2268699403/Stm32_Project/基于stm32f103的两轮自平衡车/平衡车_ESP拓展/progress.md

# 进度日志

## 会话：2026-07-16

### 阶段 1：需求与发现
- **状态：** complete
- **开始时间：** 2026-07-16
- 执行的操作：
  - 分析了 STM32 平衡车完整代码结构
  - 确认 GPIO 引脚占用和可释放资源
  - 查阅 MiMo API 文档（音频理解 + TTS）
  - 确定 ESP32-S3-R16N8 硬件方案
  - 与用户确认通信方式、音色、触发方式等
  - 确认 ESP-IDF 开发框架选择

### 阶段 2：规划与结构
- **状态：** complete
- 执行的操作：
  - 设计 STM32↔ESP32 通信协议（CMD:VALUE\n 格式）
  - 设计 ESP32 任务架构（5任务+状态机）
  - 设计 API 调用流程（2轮调用：音频理解→TTS流式）
  - 绘制硬件连接方案
  - 创建规划文档(task_plan.md, findings.md, progress.md)
  - 更新 AGENTS.md
- 创建/修改的文件：
  - 平衡车_ESP拓展/task_plan.md
  - 平衡车_ESP拓展/findings.md
  - 平衡车_ESP拓展/progress.md
  - AGENTS.md (追加 ESP32 拓展章节)

### 阶段 3：STM32 侧实现
- **状态：** in_progress
- 待修改文件：
  - Hardware/USART2.h
  - Hardware/USART2.c
  - User/PID.h
  - User/main.c

### 阶段 4：ESP32 侧实现
- **状态：** pending
- 待创建文件：
  - CMakeLists.txt, sdkconfig.defaults, partitions.csv
  - main/main.c, wifi_mgr.c/h, recorder.c/h, player.c/h
  - mimo_api.c/h, uart_bridge.c/h, app_state.h

### 阶段 5：遥控器扩展
- **状态：** pending

### 阶段 6：联调与验证
- **状态：** pending

### 阶段 7：交付
- **状态：** pending

## 测试结果
| 测试 | 输入 | 预期结果 | 实际结果 | 状态 |
|---|---|---|---|---|
| (暂无) | | | | |

## 错误日志
| 时间戳 | 错误 | 解决方案 |
|---|---|---|
| (暂无) | | |

## 五问重启检查
| 问题 | 答案 |
|---|---|
| 我在哪里？ | 阶段 3 — STM32 侧实现 |
| 我要去哪里？ | 阶段 3-7：STM32改造→ESP32开发→遥控器→联调 |
| 目标是什么？ | ESP32 语音AI控制平衡车 |
| 我学到了什么？ | 见 findings.md |
| 我做了什么？ | 创建规划文档，更新 AGENTS.md |
