2268699403/Stm32_Project/原理图/平衡车底板.pdf

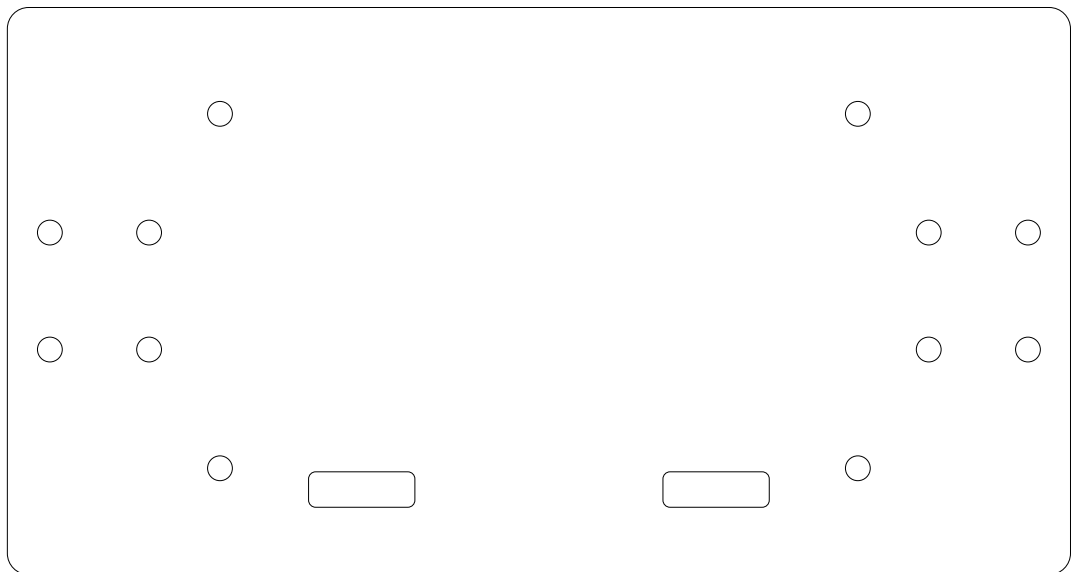
[picture p1: figure]
