2268699403/Stm32_Project/STM32F103C8T6平衡车系统开发日志.md

# STM32F103C8T6 平衡车系统 开发日志

## 2026-04-08 | 系统框架搭建与OLED驱动移植

### 今日核心目标

在Keil5 MDK环境下创建基于STM32标准外设库的工程框架。

成功移植江协科技提供的0.96寸OLED (I2C接口) 显示屏驱动程序，并完成基本功能测试。

### 具体工作内容

**工程框架搭建**：

使用STM32 Standard Peripheral Library创建了针对STM32F103C8T6的裸机工程。 完成系统时钟、GPIO、延时等基础模块的初始化配置。

**OLED驱动移植与配置**：

**硬件接口配置**： 将提供的 `OLED.c`和 `OLED.h`文件集成到工程中。将OLED的I2C引脚(SCL, SDA)配置在`GPIOB`的`Pin_8`与`Pin_9`，并初始化为开漏输出模式，在`OLED_GPIO_Init`函数中实现。

**功能验证**：调用`OLED_Init()`初始化后，依次测试了清屏(`OLED_Clear`)、显示字符串(`OLED_ShowString`)、显示数字(`OLED_ShowNum`)及画线(`OLED_DrawLine`)等基础功能，确认驱动工作正常。

### **问题与解决**

**问题**：无（驱动代码完整，移植顺利）。

### **下一步计划**

定时器开发：配置STM32通用定时器TIM1，实现精准的毫秒级定时中断，为系统提供时间基准。

## 2026-04-09 | 系统定时基准与中断服务框架搭建

### **今日核心目标**

配置STM32F103C8T6的高级定时器TIM1，实现精准的1毫秒定时中断，为整个平衡车控制系统提供稳定、可靠的时间基准，并初步建立中断服务例程的框架。

### **具体工作内容**

**定时器硬件初始化**： 根据提供的代码，完成了TIM1的完整初始化流程。使能了TIM1的APB2总线时钟，并选择内部时钟源。 完成了关键参数配置：将系统72MHz主频进行72分频，得到1MHz的计数器时钟；设置自动重装载值为999，实现每计数1000次（即1ms）产生一次更新中断。 配置了NVIC，将TIM1更新中断的抢占优先级和子优先级均设置为0，以确保中断能及时响应。

**中断服务程序开发**： 编写了标准的中断服务函数 `TIM1_UP_IRQHandler`。在函数中，首要操作是检查并清除“更新中断”标志位，这是防止中断重复进入的关键步骤。

### 关键代码

```c
// 位于 Timer_Init() 函数中的定时器结构体配置
TIM_TimeBaseInitStructure.TIM_Period = 1000 - 1;     // 自动重装载值 (ARR)
TIM_TimeBaseInitStructure.TIM_Prescaler = 72 - 1;    // 预分频器 (PSC)
// 计算公式: Tout = (ARR+1) * (PSC+1) / Tclk
// 此处: (1000) * (72) / 72,000,000 Hz = 0.001s = 1ms

// 位于 TIM1_UP_IRQHandler 中的中断服务与任务调度框架
void TIM1_UP_IRQHandler(void)
{	
    if (TIM_GetITStatus(TIM1, TIM_IT_Update) != RESET) // 1. 判断中断源
    {
		static uint16_t ms_count = 0; // 静态变量，用于软件计时
		ms_count++;
		
		/* 示例：将20ms周期任务放入中断 */
		if(ms_count >= 20)
		{
			
		}
		
        TIM_ClearITPendingBit(TIM1, TIM_IT_Update); // 2. 清除中断标志	        
    }
}
```

### **问题与解决**

**问题**：本次开发过程顺利，未遇到阻塞性技术问题。

### **下一步计划**

1. **USART串口驱动开发**：配置USART1，实现与上位机的串口通信。
2. **调试框架搭建**：基于串口，基于可变参函数自定义printf输出函数，构建一个方便的实时调试信息输出通道，便于后续PID调试、数据监控等。

## 2026-04-11 | 多路串口通信与调试框架构建

### **今日核心目标**

完成两路异步串行通信接口（USART1与USART2）的初始化与基础发送功能开发，构建可用于系统调试、参数监控及未来无线模块通信的稳定串行数据链路。核心是编写可重用的自定义格式化输出函数。

### **具体工作内容**

**双路USART硬件初始化**：

**USART1**：配置于PA9 (TX)、PA10 (RX)，挂载在APB2总线，时钟频率72MHz，初始化波特率为9600。

**USART2**：配置于PA2 (TX)、PA3 (RX)，挂载在APB1总线，时钟频率36MHz，初始化波特率同样为9600。代码中已正确处理了其总线时钟的独立使能。

两路串口均配置为：8位数据位，1位停止位，无校验位，无硬件流控制，全双工模式。

**通信函数库开发**：

为每个串口编写了分层级的发送函数：`USARTx_SendByte`（发送单字节）、`USARTx_SendString`（发送字符串）。

**关键重构**：实现了自定义的 `USARTx_Printf`函数。此函数利用C标准库的 `stdarg.h`头文件处理可变参数，内部调用 `vsprintf`将格式化的字符串输出到内部缓冲区，再通过字符串发送函数输出，完美替代了资源消耗大的标准库 `printf`，为系统调试提供了极大便利。

### 关键代码

```c
// 关键点1：USART初始化参数配置结构体 (以USART1为例)
USART_InitTypeDef USART_InitStructure;
USART_InitStructure.USART_BaudRate = 9600;
USART_InitStructure.USART_WordLength = USART_WordLength_8b;
USART_InitStructure.USART_StopBits = USART_StopBits_1;
USART_InitStructure.USART_Parity = USART_Parity_No;
USART_InitStructure.USART_Mode = USART_Mode_Rx | USART_Mode_Tx;
USART_InitStructure.USART_HardwareFlowControl = USART_HardwareFlowControl_None;
USART_Init(USART1, &USART_InitStructure);
// 注意：USART2的时钟总线（APB1）与USART1（APB2）不同，需单独使能。

// 关键点2：自定义可变参数格式化输出函数 (摘取自USART1_Printf)
void USART1_Printf(char *format, ...)
{
	char String[128];                // 临时缓冲区
	va_list arg;                    // 定义可变参数列表指针
	va_start(arg, format);          // 初始化arg，指向format后的第一个参数
	vsprintf(String, format, arg);  // 将格式化字符串写入缓冲区
	va_end(arg);                    // 结束可变参数获取
	USART1_SendString(String);      // 发送格式化后的字符串
}
// 此实现避免了直接链接标准库printf，显著节省代码空间。
```

### **遇到的问题与解决方案**

**技术难点：实现灵活的格式化输出** 

**问题**：需要实现一个类似 `printf`的函数，以支持方便地输出调试信息（如：`“Pitch: %.2f\n”`），但又不希望直接使用体积庞大的标准库 `printf`。 

**解决方案**：如关键代码所示，采用 **可变参数函数** 实现。使用 `va_list`、`va_start`、`vsprintf`和 `va_end`这一套标准流程，将格式解析和变量参数处理在用户自定义函数内完成，最终仅发送格式化完毕的字符串，实现了功能与代码体积的平衡。

**硬件连接：CH340通信失败**

**问题**：在独立供电（平衡车用电池，CH340模块接电脑USB）的情况下，仅连接TX、RX，串口无法通信，上位机接收不到数据。 

**分析与解决**：在电气上，两个独立的系统要保证通信，必须要有共同的参考地（GND）。仅连接信号线而未连接地线，会导致双方电平判断标准不一致，从而通信失败。 

**解决方案**：将CH340模块的GND引脚与STM32系统的GND（如开发板的GND引脚）用杜邦线连接，建立共地。连接后通信立即恢复正常。

### **下一步计划**

**非阻塞式按键检测开发**：利用已实现的1ms定时中断，设计一个状态机驱动的按键扫描程序，实现单击、长按的识别，且不占用主循环阻塞等待。

### 2026-04-12 | 非阻塞式按键驱动开发与状态机实现

### **今日核心目标**

完成四路独立按键的非阻塞式检测驱动开发，实现按键的单击与长按（>1秒）识别，为系统提供可靠的人机输入接口，并为后续的菜单控制、参数调整等功能奠定基础。

### **具体工作内容**

**硬件初始化**： 根据`Key.h`中的定义，将`Key1`(PB1)， `Key2`(PB0)， `Key3`(PA5)， `Key4`(PA4) 初始化为上拉输入模式。当按键未按下时，引脚被内部上拉电阻拉至高电平；按键按下时，引脚被拉至低电平。

**状态扫描函数 (`Key_Scan`)**： 该函数被放置在`TIM1`的1ms中断服务程序中，**每20ms调用一次**，实现了周期性的非阻塞扫描。 函数核心是一个**状态机**：通过对比本次读取的引脚状态(`StateX`)与上次保存的状态(`last_StateX`)，来检测按键的“按下边沿”和“释放边沿”，并分别设置`PressedX`和`ReleasedX`标志位。 在按键持续按下的周期中，软件计数器`countX`会递增，用于计时。

**模式判断函数 (`Key_Mode`)**： 此函数在主循环中被周期性调用。 其逻辑是：当检测到某个按键的`ReleasedX`（释放）标志被置位时，根据该按键按下过程中累计的`countX`值进行判断。 **判定逻辑**：若`countX >= 50`（即20ms * 50 = 1000ms），则判定为长按，`KeyX_Mode`赋值为`2`；否则判定为短按，赋值为`1`。判断完成后，将所有相关标志和计数器清零，为下一次按键事件做准备。

### **关键代码**

```c
// 关键点1：Key_Scan函数中的状态机与边沿检测 (以Key1为例)
/* 获取按键上次状态 */
last_State1 = State1;
/* 读取当前实际引脚电平 */
State1 = GPIO_ReadInputDataBit(GPIOB, GPIO_Pin_1);

if(State1 == 0 && last_State1 == 1)  // 条件1：当前按下 & 上次松开 -> 检测到按下边沿
{
    Pressed1 = 1; // 设置“按下”事件标志
}
else if(State1 == 1 && last_State1 == 0) // 条件2：当前松开 & 上次按下 -> 检测到释放边沿
{
    Released1 = 1; // 设置“释放”事件标志
}
else if(State1 == 0 && last_State1 == 0) // 条件3：持续按下状态
{
    count1++; // 按下时间计数器累加 (每20ms加1)
}
// 注意：此设计有效消除了按键抖动的影响。

// 关键点2：Key_Mode函数中的长按/短按判决 (以Key1为例)
void Key_Mode(void)
{
    if(Released1) // 仅在按键释放后进行最终判决
    {
        if(!Key1_Mode && count1 >= 50)  // 长按判决
        {
            Key1_Mode = 2; // 长按状态码
            count1    = 0; // 计数器清零
            Pressed1  = 0; // 事件标志清零
            Released1 = 0;
        }        
        else if(!Key1_Mode && count1 < 50)  // 短按判决
        {
            Key1_Mode = 1; // 短按状态码
            count1    = 0;
            Pressed1  = 0;
            Released1 = 0;
        }       
    }
}

```

### **遇到的问题与解决方案**

**问题**：在初步测试时，将`Key1_Mode`的数值实时显示在OLED上。发现长按超过1秒后，OLED能正确显示`2`（长按有效），但松开按键的瞬间，显示立刻变成了`1`（短按），逻辑出现错误。

**分析与调试**：此现象表明，在长按判决之后、按键松开之前，程序又进行了一次短按判决。检查原始代码逻辑发现，**长按判决和短按判决被放置在了不同的条件分支或执行时序中**。

**解决方案**：**将长按和短按的最终判决逻辑统一放置在“按键释放”(`ReleasedX == 1`)这个唯一的事件之后进行**，并保证只执行一次。如关键代码所示，在`Key_Mode`函数中，当检测到释放事件时，根据`countX`的值进行一次性的、排他性的判断（`countX >= 50`为长按，否则为短按），判决后立即将所有相关状态清零。这确保了一次按键动作只产生一个明确的状态结果（1或2）。

### **下一步计划**

**PCB硬件修复**：修改当前PCB中连接蓝牙模块的串口引脚网络错误，进行重新打板。

**姿态解算基础**：初始化I2C，配置MPU6050，读取姿态传感器原始数据。

## 2026-04-13 | MPU6050姿态传感器驱动开发与I2C通信实现

### **今日核心目标**

完成姿态传感器的核心驱动开发。具体包括：配置STM32的硬件I2C2外设，实现底层的单字节与多字节读写函数；完成MPU6050模块的初始化、寄存器配置，并成功读取其原始的加速度计、陀螺仪及温度数据，为后续的姿态解算奠定数据基础。

## **具体工作内容**

**I2C2硬件初始化**：

 在 `MPU6050_Init`函数中，使能了 `GPIOB`和 `I2C2`的时钟。 将 `PB10`(SCL) 和 `PB11`(SDA) 配置为**复用开漏输出** 模式，这是标准I2C通信的推荐配置。 配置I2C外设：设置模式为`I2C_Mode_I2C`，时钟速度为400kHz，占空比为`I2C_DutyCycle_2`，并启用应答。

**I2C底层读写函数开发**：

 **单字节写入 (`I2C_WriteByte`)**：严格遵循I2C协议时序，依次实现了起始信号、发送设备地址（写）、发送寄存器地址、发送数据、停止信号，并在每个步骤后通过`I2C_CheckEvent`函数检查事件标志位，确保通信可靠性。 **单字节读取 (`I2C_ReadByte`)** 与**多字节连续读取 (`I2C_ReadBytes`)**：实现了完整的读操作流程。关键点在于执行“重复起始条件”以切换读写方向，以及在读取最后一个字节前**禁用ACK**并**发送停止条件**，这是正确的I2C主机读取序列。

**MPU6050应用层驱动**： 

**设备配置 (`MPU6050_Config`)**：通过I2C写入函数，依次配置MPU6050的电源管理（唤醒）、采样率分频器（125Hz）、陀螺仪量程（±250°/s）和加速度计量程（±2g）。 **原始数据读取 (`MPU6050_GetRawData`)**：调用`I2C_ReadBytes`函数，从传感器数据寄存器（起始地址`0x3B`）连续读取14个字节，并按照数据手册格式组合成6个16位有符号整数（加速度X/Y/Z、温度、陀螺仪X/Y/Z），存入自定义的`MPU6050_Data`结构体中。

### **关键代码**

```c
// 关键点1：I2C多字节读取函数的核心流程
uint8_t I2C_ReadBytes(uint8_t DevAddr, uint8_t RegAddr, uint8_t *Data, uint8_t Len) {
    // ... 发送起始条件、设备地址（写）、寄存器地址 ...
    I2C_GenerateSTART(I2C2, ENABLE); // 发送重复起始条件
    // ... 发送设备地址（读）...
    
    /* 关键逻辑：读取前 N-1 个字节，需回复ACK */
    if(Len > 1) {
        I2C_AcknowledgeConfig(I2C2, ENABLE);
        for(uint8_t i = 0; i < Len - 1; i++) {
            while(I2C_CheckEvent(I2C2, I2C_EVENT_MASTER_BYTE_RECEIVED) == ERROR);
            Data[i] = I2C_ReceiveData(I2C2);
        }
    }
    /* 关键逻辑：读取最后一个字节前，发送NACK和STOP信号 */
    I2C_AcknowledgeConfig(I2C2, DISABLE);
    I2C_GenerateSTOP(I2C2, ENABLE);
    while(I2C_CheckEvent(I2C2, I2C_EVENT_MASTER_BYTE_RECEIVED) == ERROR);
    Data[Len-1] = I2C_ReceiveData(I2C2);
    
    I2C_AcknowledgeConfig(I2C2, ENABLE); // 恢复ACK使能，为下次通信做准备
    return 0;
}

// 关键点2：从原始字节数据合成16位传感器数据
pData->Accel_X = (buffer[0] << 8) | buffer[1]; // 高字节在前，低字节在后
pData->Accel_Y = (buffer[2] << 8) | buffer[3];
pData->Accel_Z = (buffer[4] << 8) | buffer[5];
pData->Temp    = (buffer[6] << 8) | buffer[7];
pData->Gyro_X  = (buffer[8] << 8) | buffer[9];
pData->Gyro_Y  = (buffer[10] << 8) | buffer[11];
pData->Gyro_Z  = (buffer[12] << 8) | buffer[13];

```

### **遇到的问题与解决方案**

**头文件包含与宏定义失效**：

 **问题**：在`MPU6050.c`文件中编写的代码，无法识别`MPU6050_ADDR_W`、`MPU6050_WHO_AM_I`等寄存器地址宏定义，导致编译错误。 

**原因与解决**：这些宏定义均在`MPU6050_Reg.h`头文件中。虽然`MPU6050.c`包含了`MPU6050.h`，但`MPU6050.h`中并未包含`MPU6050_Reg.h`。**C语言的编译单元是源文件(`.c`)**，每个`.c`文件需要直接包含它所依赖的所有头文件。因此在`MPU6050.c`的开头添加了`#include "MPU6050_Reg.h"`，问题解决。这是一个关于C语言编译与链接机制的重要实践认知。

**低级语法与API错误**： 

**问题**：代码中存在中文分号`；`导致编译失败；在调用`I2C_CheckEvent`函数时，使用了错误的状态标志位。

 **解决**：利用AI编程助手的实时语法检查与代码补全功能，快速定位并修正了这些笔误和API使用错误，显著提升了调试效率。

### **已验证结果**

硬件I2C2通信初始化成功，SCL/SDA波形通过逻辑分析仪验证，符合400kHz I2C标准。

MPU6050设备ID读取成功，`WHO_AM_I`寄存器返回值正确，确认通信链路畅通。

成功读取原始数据。在主函数中循环调用`MPU6050_GetRawData`，并将陀螺仪X、Y、Z轴原始值实时显示在OLED屏幕上，数值随传感器晃动而灵敏变化，验证了数据读取的完整性与正确性。

### **下一步计划**

**DMA数据传输优化**：目前采用查询方式读取MPU6050的14字节数据，会短暂阻塞CPU。计划配置DMA通道，实现I2C数据到内存数组的自动搬运，将CPU解放出来以执行更关键的控制任务，提升系统实时性。

## 2026-04-17 | 电机驱动与控制执行器开发

### **今日核心目标**

完成平衡车核心执行机构——直流减速电机的驱动与控制。具体包括：配置`TIM2`定时器的两路PWM输出通道，生成用于电机调速的PWM波形；编写完整的电机驱动模块，实现对左右电机**正转、反转、停止**三种状态以及**无级调速**的精确控制。

### **具体工作内容**

**PWM波形生成（`PWM.c/.h`）**： 

**定时器配置**：初始化`TIM2`，时钟源选择内部时钟。通过配置预分频器(PSC)=0和自动重装载寄存器(ARR)=7199，将PWM波形频率设置为10kHz。计算过程：定时器时钟为72MHz，PWM频率 = 72MHz / ((PSC+1)*(ARR+1)) = 72,000,000 / (1 * 7200) = 10,000 Hz。此频率可有效避免电机产生可闻噪音。

 **PWM通道配置**：配置`TIM2`的通道1(PA0)和通道2(PA1)为PWM模式1，输出极性高有效，并启用输出。通过`TIM_SetComparex()`函数动态修改比较寄存器(CCRx)的值，实现占空比0-100%的调节。

**电机驱动模块（`Motor.c/.h`）**：

 **硬件接口**：使用`GPIOB`的`Pin12~15`作为TB6612电机驱动芯片的控制引脚，分别控制左右电机的方向（AIN1/AIN2, BIN1/BIN2）。 

**功能抽象**：提供了高度封装的API函数。 Motor_Init(): 初始化PWM及控制GPIO。 Motor_Direction(Motor_Id, Direction): 控制电机转向（正转`FWD`、反转`REV`、制动`STOP`）。

**关键点**：代码中根据电机ID（`Motor_L`/`Motor_R`）分别映射到正确的GPIO，并考虑了左右电机安装方向相反导致的“正转”定义不同。 `Motor_Speed(Motor_Id, Duty)`: 设置指定电机的PWM占空比（0-100），实现调速。 `Motor_Stop()`: 同时制动两个电机（将驱动芯片输入置为同电平，电机快速停止）。

**系统集成与测试（`main.c`）**： 

在主函数中编写了测试循环，交替控制左右电机以20%的占空比进行正转、反转、停止各0.5秒的周期性运动，验证了驱动电路与代码逻辑的正确性。

### 关键函数

```c
// TIM2 PWM定时器基础配置 (PWM.c)
TIM_TimeBaseInitStructure.TIM_Period = 7200 - 1;      // 自动重装载值 ARR
TIM_TimeBaseInitStructure.TIM_Prescaler = 0;          // 预分频器 PSC
// 计算得 PWM 频率 = 72MHz / ((0+1)*(7200)) = 10 kHz
// 计算得 PWM 分辨率 = 7200 counts

// 电机方向控制函数中的逻辑判断 (Motor.c)
void Motor_Direction(uint8_t Motor_Id, uint8_t Direction) {
    if (Motor_Id == Motor_L) { // 左电机控制逻辑
        if (Direction == Motor_FWD) { // 左电机“正转”定义为前进方向
            GPIO_SetBits(GPIOB, BIN_2);
            GPIO_ResetBits(GPIOB, BIN_1);
        } else if (Direction == Motor_REV) { // 反转
            GPIO_SetBits(GPIOB, BIN_1);
            GPIO_ResetBits(GPIOB, BIN_2);
        } else if (Direction == Motor_STOP) { // 制动（短路刹车）
            GPIO_SetBits(GPIOB, BIN_1);
            GPIO_SetBits(GPIOB, BIN_2);
        }
    } else if (Motor_Id == Motor_R) { // 右电机控制逻辑
        if (Direction == Motor_FWD) { // 右电机“正转”定义为前进方向
            GPIO_SetBits(GPIOB, AIN_1);
            GPIO_ResetBits(GPIOB, AIN_2);
        }
        // ... 其他状态类似
    }
}
// 注：AIN1/AIN2控制右电机，BIN1/BIN2控制左电机，正反转电平逻辑相反以实现同向转动。
```

### **遇到的问题与解决方案**

**问题**：在初步调试时，电机仅能极其缓慢转动，即使将PWM占空比设置为100%，也无力带动车轮。

**分析与调试**： TB6612在仅接`VCC`未接`VM`时，其内部逻辑电路可工作，H桥功率输出级无法正常工作，但可能存在极微弱的漏电流导致电机能“蠕动”，造成了“有控制信号但无力”的现象。

**解决方案**：为电机驱动模块接入独立的`VM`功率电源，并确保与单片机的`GND`共地。接通后，电机立即能有力、快速地响应调速指令。

### **已验证结果**

 用示波器测量`PA0`和`PA1`引脚，确认产生了频率10kHz、占空比可精确调控的PWM波形。

左右电机可独立受控，分别实现正转、反转、制动，且转动方向符合代码中为平衡车定义的“前进”方向。

`Motor_Speed`函数控制线性度良好，占空比从10%到90%变化时，电机转速呈现明显的阶梯变化。

急停功能(`Motor_Stop`)响应迅速，电机能在短时间内停止，无明显滑行。

### **项目风险与调整记录**

**DMA数据搬运计划暂停**：在尝试为MPU6050的I2C通信配置DMA时，程序在`I2C_CheckEvent`的等待循环中卡死，初步判断为I2C总线状态机与DMA传输时序冲突导致的死锁。为确保项目主干进度，决定暂时搁置DMA优化，维持当前查询式读取。此优化将在主体控制算法稳定后，作为性能提升点重新评估。

### **下一步计划**

**编码器接口与速度反馈**：配置`TIM3`和`TIM4`的编码器接口模式，用于读取连接在左右电机上的正交编码器信号，从而获取电机的实时转速，为后续的速度闭环PID控制提供反馈量。

**速度计算任务**：编写一个在定时中断中运行的函数，定期读取编码器计数值并换算为实际转速。

## 2026-04-18 | 编码器测速与蓝牙模块重置

### **今日核心目标**

实现平衡车速度闭环控制的关键反馈环节。具体包括：完成`TIM3`和`TIM4`的正交编码器接口模式配置，以捕获电机编码器脉冲；在系统1ms定时中断中周期性地读取并计算左右电机的实时转速（RPM）与方向；重置蓝牙模块，为后续的无线调参与监控做好准备。

### **具体工作内容**

**编码器硬件接口配置（`Encoder_Init`）**：

使能了`TIM3`、`TIM4`及对应GPIO的时钟。将编码器A/B相输入引脚配置为上拉输入模式(`GPIO_Mode_IPU`)。配置`TIM3`和`TIM4`的时基单元，设置`Prescaler=1-1`, `Period=65536-1`，将计数器配置为16位无符号模式。

调用`TIM_EncoderInterfaceConfig`函数，将定时器工作模式设置为`TIM_EncoderMode_TI12`，此模式可同时对A、B两相的边沿进行计数，实现四倍频和提高测向精度。

根据电机物理安装方向，分别设置`TIM3`和`TIM4`的输入捕获极性，以匹配实际的转向逻辑。

**测速算法实现与系统集成**：

测速函数（`Encoder_GetState`）：在`Timer.c`的`TIM1_UP_IRQHandler`中断服务函数中，每10ms调用一次此函数。函数读取`TIM3`和`TIM4`的计数器值（`CNT`），并立即将计数器清零，为下一个10ms周期做准备。

转速计算：通过公式 `RPM = (脉冲计数 * 6000.0f) / (编码器单圈脉冲数44 * 减速比9.6)`将周期内的脉冲数转换为转速（RPM）。编码器分辨率为11线（四倍频后44），电机减速比为9.6。

主循环应用：在`main.c`中，将计算得到的`RPM_L`和`RPM_R`实时显示在OLED屏幕上，并进行验证。

**蓝牙模块修复**：

根据数据手册，将模块的P16引脚接地100ms，重置出厂设置，通过串口助手发送`AT`指令，成功接收到`OK`响应，确认模块通信功能恢复正常，为后续的无线数据传输扫清了障碍。

### 关键代码

```c
// TIM3/TIM4 编码器接口模式配置 (Encoder.c)
TIM_EncoderInterfaceConfig(TIM3, TIM_EncoderMode_TI12, TIM_ICPolarity_Rising, TIM_ICPolarity_Rising);
TIM_EncoderInterfaceConfig(TIM4, TIM_EncoderMode_TI12, TIM_ICPolarity_Rising, TIM_ICPolarity_Rising);
// 参数说明：TIM_EncoderMode_TI12 表示在TI1和TI2的边沿都计数，实现4倍频。
// 后两个参数分别设置通道1和通道2的输入捕获极性，需根据编码器实际相位和电机转向调整。

// 周期性的转速计算与计数器清零 (Encoder.c)
void Encoder_GetState(void)
{
    int16_t Count_L = TIM_GetCounter(TIM4); // 获取左电机编码器在10ms内的脉冲计数值
    int16_t Count_R = TIM_GetCounter(TIM3); // 获取右电机编码器在10ms内的脉冲计数值
    // 转速换算公式：RPM = (ΔCount * (1000ms/10ms) * 60s) / (PPR * GearRatio)
    RPM_L = (Count_L * 6000.0f) / (44.0f * 9.6f); // 左电机转速
    RPM_R = (Count_R * 6000.0f) / (44.0f * 9.6f); // 右电机转速
    // 清零计数器，为下一个测量周期做准备
    TIM_SetCounter(TIM3, 0);
    TIM_SetCounter(TIM4, 0);
}

// 在1ms定时中断中调度测速任务 (Timer.c)
void TIM1_UP_IRQHandler(void)
{
    if (TIM_GetITStatus(TIM1, TIM_IT_Update) != RESET)
    {
        static int count_e = 0;
        count_e++;
        if(count_e >= 10) // 每10ms执行一次
        {
            Encoder_GetState(); // 执行测速
            count_e = 0;
        }
        TIM_ClearITPendingBit(TIM1, TIM_IT_Update);
    }
}
```

### **遇到的问题与解决方案**

**1**.**编码器无计数与电机转向错误**： 

**问题**：读取`TIM3`/`TIM4`的`CNT`寄存器值始终为0，且`Motor.c`中定义的电机转向与实际物理转向不符。 

**分析与调试**： 首先检查代码，确认编码器接口配置正确。 使用万用表测量编码器模块的VCC和GND引脚，发现电压反向。进一步检查杜邦线接线，发现编码器电机的电源线与信号线在接插件上对称接反，导致编码器未上电，自然无法计数。此接线错误也导致之前`Motor.c`中为修正物理转向而定义的宏与实际GPIO映射关系混乱。 

**解决方案**：重新正确连接编码器接线。同时，摒弃了在`Motor.h`中使用自定义宏映射引脚号的方案，改为在`Motor.c`的`Motor_Direction`函数中直接使用`GPIO_Pin_x`等标准库宏定义来控制具体引脚，消除了因宏定义映射错误导致逻辑混乱的风险。

**2**.**Keil编译缓存导致控制失效**： 

**问题**：在修复电机转向逻辑，交换了`Motor.h`中部分控制引脚的宏定义名称后，重新编译下载程序，电机无任何响应。 

**原因与解决**：怀疑是Keil MDK的编译缓存或头文件依赖关系未及时更新，导致实际生效的宏定义与源代码不一致。解决方案是执行一次“Rebuild All”，并删除工程目录下的`Objects`和`Listings`输出文件夹，确保完全重新编译。为从根本上避免此类问题，采纳了解决方案1中的做法，减少了中间宏定义的层级。

**3**.**蓝牙模块无响应**： 

**问题**：尝试通过串口发送AT指令配置HC-04蓝牙模块，模块无任何回复。

 **解决**：查阅模块数据手册，找到出厂重置方法。将模块的16引脚RST拉低100ms进行复位，随后通过串口发送`AT`，成功收到`OK`回复，模块恢复至默认状态。

### **已验证结果**

左右电机的编码器信号能被`TIM3`/`TIM4`正确捕获，`CNT`值随轮子转动而变化。

在`main`函数的循环中，通过OLED屏幕能稳定显示计算出的`RPM_L`和`RPM_R`数值，该数值能正确反映电机的正转、反转和停止。

电机控制方向与编码器测得的转向符号一致，验证了物理接线与软件逻辑已匹配。

蓝牙模块AT指令通信恢复正常，为后续开发奠定了基础。

**下一步计划**：

**完善USART2蓝牙传输功能**：基于已修复的蓝牙模块，编写数据打包与发送函数，将电机转速等系统状态通过蓝牙发送到上位机。

**驱动代码优化与封装**：对现有模块的接口和初始化流程进行梳理和优化，提高代码的模块化程度和可读性。

**准备姿态解算**：开始研究并编写MPU6050传感器数据的滤波与融合算法，为平衡车最核心的姿态控制环节做准备。

## 2026-04-19 | 传感器融合与姿态解算实现

### **今日核心目标**

完成平衡车最核心的姿态感知环节。具体包括：优化底层驱动代码的稳定性与响应逻辑；基于MPU6050的原始数据，分别通过加速度计和陀螺仪计算俯仰角，并运用互补滤波算法进行数据融合，最终输出一个稳定、准确且动态响应良好的俯仰角，为后续的直立控制提供可靠的状态输入。

### **具体工作内容**

**驱动层稳定性与逻辑优化**： 

**按键逻辑优化**：将`Key_Mode`函数的判断逻辑从“仅在松手(`Released`)时判决”优化为“长按超过1秒（`count >= 50`）时立即更新状态，短按仍在松手时判决”。此举使长按触发更及时，提升了人机交互体验。 **I2C通信加固**：在`MPU6050.c`的`I2C_ReadByte`和`I2C_ReadBytes`等函数中，将所有`while(I2C_CheckEvent(...))`循环替换为自定义的`WaitEvent`函数。该函数内置超时退出机制，有效防止了因I2C总线被意外干扰而导致的程序永久卡死，显著提升了系统鲁棒性。

**姿态解算算法实现与调试**：

 **传感器数据处理**： 加速度计俯仰角 (`AngleAcc`)：利用 `atan2(Accel_X, Accel_Z) * 180 / π`公式计算。`atan2`函数可正确处理四个象限，得到范围在-180°~180°之间的角度。此角度在静态时准确，但动态响应慢且易受线性加速度干扰。 陀螺仪俯仰角 (`AngleGyro`)：对陀螺仪Y轴（俯仰轴）的角速度进行积分。公式为：`AngleGyro = Angle + (-Gyro_Y / 32768 * 2000 * 0.01)`。其中，`-Gyro_Y`用于统一方向，`2000`对应量程±2000°/s，`0.01`是10ms的积分周期（`dt`）。此角度动态响应好，但存在积分漂移。 **互补滤波融合**：采用一阶互补滤波公式 `Angle = Kp * AngleAcc + (1 - Kp) * AngleGyro`。设置较小的`Kp=0.01`，意味着最终角度`Angle`主要由陀螺仪积分结果主导，同时用加速度计角度对其低频漂移进行微量修正，实现了优势互补。 **传感器校准**：在`MPU6050_GetRawData`函数中，对陀螺仪Y轴数据进行了零偏校准（`pData->Gyro_Y -= 43`），以抑制其零点漂移，这是减小姿态角稳态误差的关键步骤。

**系统调度与架构优化**：

 将`MPU6050_GetRawData`函数的调用从主循环移至`TIM1`的1ms定时中断服务函数中，并设置为每10ms执行一次。这为I2C总线操作提供了稳定的、可控的时序间隔，避免了主循环中高频调用可能导致的I2C状态机冲突，从系统架构上杜绝了卡死的风险。

### 关键代码

```c
// 计算基于加速度计的俯仰角（单位：度）
AngleAcc  = atan2(pData->Accel_X, pData->Accel_Z) * 180.0f / 3.14159f;
// 计算基于陀螺仪积分的俯仰角（单位：度）
AngleGyro = Angle + (-pData->Gyro_Y / 32768.0f) * 2000.0f * 0.01f;
// 一阶互补滤波融合
float Kp = 0.01f; // 加速度计权重，取值较小以信任陀螺仪
Angle = Kp * AngleAcc + (1.0f - Kp) * AngleGyro;

// I2C事件等待超时机制 (MPU6050.c)
void WaitEvent(I2C_TypeDef* I2Cx, uint32_t I2C_EVENT)
{
    uint32_t timeout = 50000; // 超时计数
    while(I2C_CheckEvent(I2Cx, I2C_EVENT) == ERROR)
    {
        timeout--;
        if(timeout <= 1) // 超时后强制跳出，避免死锁
        { break; }
    }    
}
// 应用示例：在I2C_ReadByte等函数中，用WaitEvent替换原有的while(I2C_CheckEvent...)

// 定时中断中的任务调度 (Timer.c)
void TIM1_UP_IRQHandler(void)
{
    if (TIM_GetITStatus(TIM1, TIM_IT_Update) != RESET)
    {
        static int count_1 = 0;
        count_1++;
        if(count_1 >= 10) // 10ms任务
        {
            MPU6050_GetRawData(&Data); // 姿态解算
            Encoder_GetState();        // 速度反馈
            count_1 = 0;
        }
        // ... (其他任务)
        TIM_ClearITPendingBit(TIM1, TIM_IT_Update);
    }
}
```

### **遇到的问题与解决方案**

**蓝牙模块无法连接**：

 **问题**：HC-04蓝牙模块可以通过USB转串口进行AT指令配置和问答，但无法与手机等设备完成配对连接。 

**分析与解决**：此问题可能由多种原因导致，如模块工作模式（主/从）设置错误、配对密码不正确、或硬件射频部分损坏。

**作为风险记录**：目前暂不影响核心算法开发，但需后续排查。

**主循环高频读取MPU6050导致卡死**： 

**问题**：初期在主循环中无延迟地调用`MPU6050_GetRawData`，程序运行不久后卡死。 

**原因**：I2C通信是阻塞式且有时序要求的。在主循环中超高频率调用，会导致I2C状态机尚未完成上一次操作，就开始了下一次，标志位混乱，最终卡在等待事件的`while`循环中。 

**解决方案**：采取了双重保障。架构上，将读取函数移至10ms定时中断，保证调用间隔。代码上，为所有I2C事件等待增加了`WaitEvent`超时机制。两者结合，彻底解决了此问题。

**串口打印触发硬错误（HardFault）**： 

**问题**：调用`USART1_Printf`输出角度值时，系统进入硬错误中断，程序崩溃。 

**原因**：`USART1_Printf`函数内部使用`vsprintf`将格式字符串写入一个固定大小的栈数组`String[128]`。当格式化输出的字符串长度超过128字节时，会发生栈缓冲区溢出，破坏相邻内存，从而触发硬错误。 

**解决方案**：将`vsprintf`替换为更安全的`vsnprintf`。`vsnprintf`的第三个参数指定了目标缓冲区的大小，可以防止写入越界。

### **已验证结果**

按键长按响应优化有效，体验提升。

I2C超时机制有效，在模拟拔插传感器时，程序能从错误中恢复，而非永久卡死。

姿态解算成功。OLED屏幕上实时显示的`Angle`数值稳定，传感器静止时波动小于0.5°，快速转动时能平滑、快速地跟踪，无显著漂移。`AngleAcc`和`AngleGyro`的数值特性符合预期。

陀螺仪零偏校准（`-43`）有效，显著降低了平衡车静止时的角度漂移速度。

### **下一步计划**

**优化调试输出**：针对`vsnprintf`效率较低的问题，评估影响。优化数据发送函数，或仅在需要时使能调试输出。

**实现直立控制**：引入PID控制算法。首先设计直立环（角度环），以融合后的`Angle`作为反馈，计算PWM输出控制电机，尝试让小车在手动扶正后能短暂保持直立。

## 2026-04-20 | 直立环PID控制实现与系统调优

### **今日核心目标**

实现平衡车最核心的控制功能——直立环控制。基于已解算出的稳定俯仰角，设计并调试角度环PID控制器，最终使平衡车在无人扶持的情况下能够实现动态平衡，并完成相关驱动模块的优化与调试框架的完善。

### **具体工作内容**

**调试框架完善**： 成功修复了蓝牙模块（USART2）的通信功能。通过上位机软件实时接收并图形化显示角度目标值、实际值及PID输出的波形，为PID参数整定提供了直观、高效的视觉反馈工具。

**电机驱动模块优化**： 重构了`Motor_Direction`函数，将电机“方向”与“速度”的控制逻辑统一。函数输入参数`Duty`为`int16_t`类型的有符号数，其符号代表转向（正为前进，负为后退），绝对值代表PWM占空比。此举简化了上层控制逻辑，使PID输出可直接作为电机输入。

**直立环PID控制器实现与调参**： **控制器设计**：在`PID.c`中实现了增量式PID算法。`PID_Update`函数依次计算比例项(`Kp*Error`)、积分项(`Ki*ErrorInt`)和微分项(`Kd*dError`)。 **系统集成**：在`Timer.c`的10ms定时中断中，调用`PID_Angle_Update`函数。该函数以融合后的`Angle`作为反馈量(`Actual`)，以`0`作为目标值(`Target`)，计算PID输出，并转换为左右电机的PWM信号。 **参数整定**：通过观察上位机波形和车身响应，采用试凑法，依次调节`Kp`（影响回复力刚度）、`Kd`（抑制振荡）和`Ki`（消除稳态误差），最终将直立环参数整定为：`Kp=2.5`, `Ki=0.07`, `Kd=3.0`。平衡车可在手动扶正后，维持数秒的稳定直立。

### 关键代码

```c
//增量式PID算法核心 (PID.c - PID_Update函数)
void PID_Update(PID_struct *p)
{
    p->Error1 = p->Error0;                     // 保存上次误差
    p->Error0 = p->Target - p->Actual;         // 计算本次误差
    p->ErrorInt += p->Error0;                  // 误差积分（已做积分分离判断）

    // 计算PID输出：Out = Kp*e + Ki*∑e + Kd*(e - e_last)
    p->Out = p->Kp * p->Error0
           + p->Ki * p->ErrorInt
           + p->Kd * (p->Error0 - p->Error1);
    
    // 输出限幅，防止饱和
    if (p->Out > p->OutMax) p->Out = p->OutMax;
    if (p->Out < p->OutMin) p->Out = p->OutMin;
}

//电机死区与最小启动电压处理 (Motor.c - Motor_Direction函数)
if(Duty < 5 && Duty > 1){Duty = 5;}     // 1~5 区间的占空比统一提升至5
else if(Duty < -1 && Duty > -5){Duty = -5;} // -5~-1 区间统一降至-5
if(Duty > 1){ /* 正转逻辑 */ }          // 死区：-1 ≤ Duty ≤ 1 时，电机停止
else if(Duty < -1){ /* 反转逻辑 */ }
else { /* 停止逻辑 */ }
// 此处理解决了电机“启动电压”不足导致的卡顿，并消除了零点附近的抖动。

//10ms中断中的直立环调度与安全判断 (Timer.c - TIM1_UP_IRQHandler)
if(config == 1) // 平衡使能标志
{
    LED_ON(); // 指示灯亮，表示平衡模式开启
    if(Angle <= -50 | Angle >= +50) // 安全倾角监测，超过50度急停
    {
        LED_OFF();
        Motor_Stop();
    }
    else
    {
        PID_Angle_Update(); // 执行直立环PID控制
    }
}
```

### **遇到的问题与解决方案**

**电机控制参数异常**：

 **问题**：优化`Motor_Direction`函数后，传入的`Duty`参数值异常，与预期相差很大。 

**原因与解决**：检查发现，函数原型中的`Duty`参数类型仍为`uint8_t`。而PID输出为有符号整数，导致赋值时发生数据截断与符号解释错误。将形参类型修改为`int16_t`后，问题解决。

**电机运行中偶发卡顿/急停**：

 **问题**：调参过程中，电机在转动时会突然停止，造成车身剧烈抖动。 

**分析与调试**：在`PID_Angle_Update`函数中，用于暂存左右电机PWM计算结果的局部变量`PWM_L`, `PWM_R`, `AvePWM`, `DifPWM`在声明时未初始化。其初始值为栈内存中的随机数，在某些情况下会干扰最终计算结果，导致`Motor_Direction`函数收到接近0的占空比，触发停止逻辑。

 **解决**：在声明这些局部变量时，全部初始化为`0`。

**平衡车单向加速运动**：

 **问题**：调参时，小车总是缓慢地朝一个方向加速运动直至倒下，无法在零点附近维持。

 **原因**：当倾角很小时（如2°以内），PID计算出的`Duty`值很小（1~5）。此占空比低于电机的静摩擦力矩对应的启动电压，电机实际不转或转速极低，无法产生足够的回复力。

 **解决**：在`Motor_Direction`函数中增加死区与最小输出处理。将`1~5`和`-5~-1`区间的占空比统一提升至`5`和`-5`，并设置`-1~1`为死区。这确保了电机一旦启动即有足够的扭矩，同时消除了零点附近的高频开关抖动。

**平衡点存在稳态偏差**： 

**问题**：即使调整PID参数，平衡车稳定的角度点并非竖直的0度，而是有一个固定的偏差。

 **原因**：MPU6050传感器存在安装误差，或加速度计零点标定不精确，导致`AngleAcc`计算出的角度在物理竖直时不为0。这个偏差会通过互补滤波传递给`Angle`，使得控制器认为“平衡状态”是一个有倾角的状态。 

**解决**：在`MPU6050.c`的`MPU6050_GetRawData`函数中，对计算出的`AngleAcc`进行软件调零：`AngleAcc -= 0.5;`。通过实验测得竖直状态下的角度值，并用此偏移量进行补偿，使传感器读数与物理状态对齐。

### 已验证结果

蓝牙透传功能稳定，上位机能实时绘制`Target`， `Actual`， `Out`三条曲线，波形清晰，成为强大的调参工具。

直立环PID控制器工作正常。平衡车在给定参数(`Kp=2.5， Ki=0.07， Kd=3`)下，能够自主维持动态平衡

安全保护机制有效。当倾角超过±50°时，系统能立即切断电机输出，防止“飞车”造成损坏。

人机交互完善。通过按键1可一键启/停平衡控制，LED指示灯状态明确，OLED屏实时显示所有关键参数。

### 下一步计划

**实现速度环控制**：在直立环的基础上，增加外环——速度环。以编码器测量的电机转速作为反馈，通过另一个PID控制器生成一个目标角度补偿量，叠加到直立环的目标值上，从而使平衡车在保持直立的同时，能稳定在指定位置或缓慢响应速度指令，抑制“静漂”。

**实现转向环控制**：以陀螺仪Z轴角速度或两电机转速差作为反馈，设计转向环PID控制器，实现平衡车的转向控制，为最终的遥控移动做准备。

## 2026-04-24 | 速度环闭环控制与无线调参实现

### 今日核心目标

在已稳定的直立环基础上，引入并调试速度环，实现平衡车的位置锁定与抗静漂；同时完善蓝牙无线调参功能，构建完整、可靠的串级PID控制系统，提升工程的可调试性与完成度。

### 具体工作内容

**速度环PID控制器实现**： 

在`PID.c`中编写了`PID_Speed_Update`函数。该函数计算左右电机编码器转速的平均值(`AveSpeed`)作为速度环的反馈量(`Actual`)。 采用串级控制结构：速度环PID的输出，作为直立环角度目标的补偿量，直接赋值给`PID_Angle.Target`。当小车因外力产生位移时，速度环会通过微调目标角度，驱使小车回到原点，从而实现位置锁定。

**蓝牙无线调参框架完善**：

 在`USART2.c`中强化了`USART2_ParseParam`函数。该函数在中断接收的环形缓冲区中，解析格式为`“参数名:值”`的字符串（如`“Kp:0.5”`）。 通过字符串匹配(`strcmp`)和格式解析(`sscanf`)，实现了对`PID_Speed`的`Kp`， `Ki`， `Kd`及`Target`等参数的远程、实时修改。结合`USART2_Printf`函数，构成了完整的“上行修改参数，下行监控波形”的无线调试通道。

**系统集成与状态机优化**：

 在`Timer.c`的中断服务函数中，以50ms为周期调用`PID_Speed_Update`函数。 关键优化：对中断服务函数中的控制逻辑进行了重构，明确了`En`（平衡使能标志）在不同状态下的行为，并确保在异常状态（如倾角超限）下，能彻底重置所有PID控制器的积分项和目标值，从软件层面杜绝了状态残留。

### 关键代码

```c
// 速度环PID更新函数 (PID.c)
void PID_Speed_Update(void)
{
    float Speed_L = 0, Speed_R = 0;
    float AveSpeed = 0;
    
    // 1. 获取速度反馈：计算两电机平均转速
    Speed_L = RPM_L;
    Speed_R = RPM_R;
    AveSpeed = (Speed_L + Speed_R) / 2.0;
    
    // 2. 执行速度环PID运算
    PID_Speed.Actual = AveSpeed;
    PID_Update(&PID_Speed);
    
    // 3. 串级输出：速度环输出作为直立环的角度目标补偿
    PID_Angle.Target = PID_Speed.Out; // 核心：通过调整目标角度来抑制静漂
}
// 注：直立环的 `PID_Angle_Update` 函数会使用此被修正后的 `Target`。

// 蓝牙指令解析与参数赋值 
uint8_t USART2_ParseParam(char *param_name, float *param_value)
{
    char received_param[8] = {0};
    float value = 0;
    
    // 从环形缓冲区解析出完整命令字符串后...
    if(sscanf(command, "%[^:]:%f", received_param, &value) == 2)
    {
        // 匹配参数名
        if(strcmp(received_param, param_name) == 0)
        {
            *param_value = value;  // 直接赋值给目标变量（如&PID_Speed.Kp）
            return 1;
        }
    }
    return 0;
}
// 应用：在主循环中调用 USART2_ParseParam(“Kp”, &PID_Speed.Kp)，实现无线调参。

// 优化后的中断服务函数状态机 
if(count_1 >=10) // 10ms任务：直立环
{
    MPU6050_GetRawData(&Data);
    
    if(Angle <= -50 || Angle >= +50) // 状态1：倾角超限，安全保护
    {
        En = 0;
        LED_OFF();
        Motor_Stop();
        // 关键清理：重置所有控制器状态，防止残留
        PID_Angle.ErrorInt = 0;
        PID_Speed.ErrorInt = 0;
        PID_Angle.Target = 0;
    }
    else if(En == 1) // 状态2：平衡使能，正常控制
    {
        LED_ON();
        PID_Angle_Update();
    }
    else // 状态3：平衡未使能，仅监测
    {
        LED_OFF();
    }
    count_1 = 0;
}
if(count_3 >=50 && En == 1) // 50ms任务：仅在使能时运行速度环
{
    Encoder_GetState();
    PID_Speed_Update(); // 速度环
    count_3 = 0;
}
```

### 遇到的问题与解决方案

**核心Bug：RAM数据残留导致上电失控**

**问题**：程序首次下载运行正常，但断电再上电后，`Key1_Mode`自动置1（自启动平衡），且`PID_Angle.Actual`（即`Angle`）从0逐渐漂移至2.1°，导致小车持续加速直至最大转速。此Bug稳定复现，且仅注释掉所有速度环相关代码方可消除。

**深度分析与调试**：

**现象关联**：Bug与速度环代码强相关，但与是否调用无关（注释调用仍复现），指向全局数据初始化或相互影响。

**内存分析**：STM32断电后，RAM内容丢失，但上电瞬间为随机值。若未在代码中显式初始化，全局变量（如`Angle`， `En`， `Key1_Mode`）将处于不确定状态。

**根本原因**：`PID_Speed`结构体与`PID_Angle`结构体在内存中可能相邻。`PID_Speed`中的某些成员（如`Target`， `Out`）在未初始化时可能为极大的随机数（如`1.2e38`）。在`PID_Speed_Update`函数中，执行`PID_Angle.Target = PID_Speed.Out;`语句时，这个巨大的随机数被赋给了直立环的目标角度，导致失控。而`Key1_Mode`可能因内存位被随机置1而触发。

**解决方案**：

**强化初始化**：在`main`函数和状态退出时，不仅初始化变量，更关键的是重置`PID_Speed.Out`等关键输出量。

**优化状态机**：严格限定速度环(`PID_Speed_Update`)仅在平衡使能(`En==1`)时运行，从逻辑上切断异常数据的传播路径。

**软件复位**：在程序启动时，主动将关键变量赋初值。此方法结合状态机优化，最终彻底解决了该问题。

**问题**：程序运行时频繁死机并自动重启。

**解决**：测量系统供电电压，发现电池电压低于5V，导致稳压芯片无法提供稳定的3.3V。为电池充电后，系统运行恢复稳定。

**问题**：下载程序后单片机无任何反应，调试器发现PC指针卡在系统存储器（System Memory）区域，疑似运行了内置Bootloader。

**分析与解决**：检查芯片引脚，发现`BOOT0`， `PB8`， `PB9`等引脚因焊接操作导致焊锡粘连。`BOOT0`引脚被意外拉高，导致芯片从上电开始即进入系统存储器启动模式，无法执行用户Flash中的程序。重新焊接，确保引脚间绝缘，问题解决。

### 已验证结果

**速度环功能实现**：平衡车在仅有直立环时，受外力推动后会持续移动。加入速度环并适当调参后，小车能在被推开后自动回到原始位置附近，实现了位置锁定，抗干扰能力显著增强。

**蓝牙无线调参成功**：通过VOFA+上位机发送`“Kp:0.12\n”`格式的指令，能实时修改小车速度环的PID参数，并在OLED屏幕上立即显示。结合波形显示，实现了高效的远程、非接触调试。

**系统稳定性提升**：通过解决RAM残留Bug和优化状态机，系统冷启动、热复位均表现一致、稳定，未再出现上电失控现象。

### **下一步计划**

**参数整定**：精细调节速度环的PID参数（`Kp`， `Ki`， `Kd`），在“抑制静漂”和“不影响直立稳定性”之间取得最佳平衡。

**实现转向环**：以陀螺仪Z轴角速度或两电机转速差作为反馈，编写转向环PID控制器，实现通过遥控器或手机APP控制平衡车左转、右转。

**工程代码优化**：整合所有模块，清理冗余代码，增加更多注释，准备进行完整的系统测试与演示视频录制。

## 2026-04-25 | 转向闭环控制与无线遥控系统集成

### **今日核心目标**

完成平衡车控制系统的最后一个核心闭环——转向环，并实现与遥控端的无线通信。具体包括：设计并调试转向环PID控制器，将其与速度环整合为统一的“运动环”控制模块；成功移植并集成NRF24L01 2.4GHz无线模块的驱动，实现遥控器对平衡车移动与转向的实时、稳定控制。

### **具体工作内容**

**转向环控制器实现与整合**：

控制器设计：在`PID.c`中，基于已定义的`PID_Turn`结构体，完成了`PID_Move_Update`函数。该函数计算左右电机转速差(`DifSpeed = Speed_L - Speed_R`)作为转向环的反馈量(`PID_Turn.Actual`)。

串级控制整合：在同一个函数中，同步处理速度环和转向环。速度环输出用于补偿直立环目标角度，以抑制静漂；转向环输出则作为差速控制量，用于后续的电机PWM分配，实现转向。

系统集成：在`Timer.c`的定时中断中，以50ms周期调用`PID_Move_Update`，并将`PID_Turn.Out`传递到`PID_Angle_Update`函数中，参与左右电机最终PWM值的计算。

**无线遥控系统集成**：

驱动移植：移植`NRF24L01.c`驱动代码到工程中，并完成引脚初始化。

通信协议应用：在`main.c`的主循环中，持续调用`NRF24L01_Receive()`函数查询接收状态。当成功接收到遥控器发来的数据包后，解析数据包。

参数实时展示：在OLED屏幕上实时显示当前的速度目标值和转向目标值，便于监控。

### 关键代码

```c
// 运动环（速度环+转向环）更新函数
void PID_Move_Update(void)
{
    float Speed_L  = 0, Speed_R = 0;
    float AveSpeed = 0, DifSpeed = 0;
    
    Speed_L = RPM_L;
    Speed_R = RPM_R;
    AveSpeed = (Speed_L + Speed_R) / 2.0;  // 用于速度环
    DifSpeed = Speed_L - Speed_R;          // 用于转向环
    
    /* 速度环PID调控：抑制静漂，锁定位置 */
    PID_Speed.Actual = AveSpeed;
    PID_Update(&PID_Speed);
    PID_Angle.Target = PID_Speed.Out; // 速度环输出修正直立目标
    
    /* 转向环PID调控：实现差速转向 */
    PID_Turn.Actual = DifSpeed;
    PID_Update(&PID_Turn); // PID_Turn.Out 将用于后续电机差速
}

// 主循环中解析NRF24L01无线数据
if (NRF24L01_Receive() == 1) // 成功接收到一包数据
{
    uint8_t ID = NRF24L01_RxPacket[0]; // 协议：第一个字节为ID
    if (ID == 0x00) // 验证ID，防止干扰
    {
        int8_t LH = NRF24L01_RxPacket[1]; // 协议：第二个字节为左右摇杆水平量 (控制速度)
        int8_t RV = NRF24L01_RxPacket[4]; // 协议：第五个字节为右摇杆垂直量 (控制转向)
        
        PID_Speed.Target = LH;       // 遥控器直接设定速度目标值
        PID_Turn.Target  = -(RV * 10); // 遥控器设定转向目标值（比例放大）
    }            
}

// 直立环中集成转向环输出，实现差速控制
void PID_Angle_Update(void)
{
    // ... 直立环PID计算，得到 AvePWM ...
    int16_t AvePWM = -PID_Angle.Out; // 基础PWM，用于维持平衡
    int16_t DifPWM = PID_Turn.Out;   // 转向环输出的差速量
    
    // 核心：将转向差速量叠加到左右电机基础PWM上
    PWM_L = AvePWM + DifPWM / 2; // 左电机PWM
    PWM_R = AvePWM - DifPWM / 2; // 右电机PWM
    // ... 限幅后驱动电机 ...
}
```

### 已验证结果

转向环功能实现：平衡车在保持直立和位置锁定的基础上，能响应转向环的控制指令。通过设定`PID_Turn.Target`，小车能够实现流畅的左转、右转动作，验证了差速转向算法的正确性。

无线遥控成功：NRF24L01模块通信正常。遥控器端的摇杆操作能够被平衡车实时、准确地接收，并转换为对应的速度和转向指令。平衡车可受控进行前进、后退、原地转向等组合运动。

三环串级系统稳定运行：直立环、速度环、转向环三个PID控制器协同工作，平衡车系统成为一个功能完整的、可通过无线遥控自由移动的两轮自平衡机器人。

### **下一步计划**

参数精细整定：在已实现全部功能的基础上，集中精力对速度环和转向环的PID参数进行联合调试与优化，在“响应速度”、“稳定性”和“抗干扰能力”之间找到最佳平衡点，提升整体运动性能。

代码结构优化：审查并重构整个工程代码，优化模块间的接口，删除调试用的临时代码，提高代码的可读性和可维护性。

注释完善与统一：为关键函数、全局变量和重要逻辑段添加详尽、统一的注释，使项目工程更加规范。

## 2026-05-20 | 转向BUG的硬件-软件映射分析与修复

### 今日核心目标

定位并修复一个导致平衡车在低速或原地转向时，出现一个电机卡死、另一个电机剧烈抖动的严重BUG。该BUG在车辆静止、直立或高速运行时均不出现，仅在特定转向工况下触发，具有很高的隐蔽性。

### 具体工作内容

**问题现象定位**：当尝试进行低速转向或原地转向时，平衡车出现异常抖动而非平滑旋转。通过观察，发现其中一个驱动轮似乎被“锁死”，而另一个轮子则在高速正反转之间剧烈抖动，系统处于不稳定状态。

**仪器辅助分析**：使用逻辑分析仪连接到电机驱动芯片TB6612的输入引脚（PWMA, AIN1, AIN2, PWMB, BIN1, BIN2），抓取在发送转向指令时，单片机GPIO输出的实际控制波形。

**根本原因定位**：通过对比逻辑分析仪捕获的波形与`Motor.c`驱动程序中的控制逻辑，发现了一个硬件与软件映射错位的致命错误。具体为：代码中针对`Motor_L`（左电机）的操作，实际被输出到了控制右电机的引脚组（PWMA/PB12/PB13）；而针对`Motor_R`（右电机）的操作，则被输出到了控制左电机的引脚组（PWMB/PB14/PB15）。

### 遇到的问题与解决方案

**问题**：平衡车在尝试低速或原地转向时发生剧烈抖动，无法正常转向。而在直立平衡、直线行驶或高速转向时，车辆表现正常。

**根因分析**：

 **映射错误**：`Motor.c`文件中的`Motor_Direction`函数内，左、右电机的控制引脚与PWM通道定义与实际的物理接线完全交叉。即，程序中的“左电机”控制代码实际驱动了物理上的右电机，反之亦然。 

**为何之前未发现**： 直立与速度环：在这两个控制环中，计算出的左右电机PWM值始终是对称相等的（`PWM_L = PWM_R`）。即使映射错误，左右两个物理电机接收到的驱动信号在大小和方向上仍然完全相同，因此表现出正常的直立和直线运动，BUG被掩盖。 转向环的暴露：转向环的核心是差速控制，其输出`DifPWM`会被叠加到基础PWM上，形成`PWM_L = AvePWM + DifPWM/2`和 `PWM_R = AvePWM - DifPWM/2`。当车辆低速或原地转向时，用于维持平衡的`AvePWM`接近于0，`DifPWM`成为主导。此时，由于映射交叉，代码试图让“逻辑左轮”加速的动作，实际却让“物理右轮”减速，形成了控制回路正反馈，导致系统发散，表现为一个轮子卡死、另一个轮子疯狂纠偏的抖动。 离地测试的盲区：在车轮离地的调试阶段，电机空转没有负载，即使存在轻微的方向错误，也不会形成机械阻力，因此该BUG在早期功能调试中未能被发现。

**解决方案**： 修正`Motor.c`文件中`Motor_Direction`函数内的引脚与PWM通道映射关系，确保软件逻辑与硬件接线一一对应。具体修正为： `Motor_L`（左电机）绑定至 `PWMB`(TIM2_CH2) 以及方向引脚 `PB14`(IN1) 和 `PB15`(IN2)。 `Motor_R`（右电机）绑定至 `PWMA`(TIM2_CH1) 以及方向引脚 `PB12`(IN1) 和 `PB13`(IN2)。 同时，确保函数内部在设置反转PWM占空比时，传入的`-Duty`被正确取绝对值，防止数据溢出。

### 关键代码

```c
// Motor.c - Motor_Direction 函数修正核心 (修正映射关系)
void Motor_Direction(uint8_t Motor_Id, int16_t Duty)
{
    if (Motor_Id == Motor_L) // 左电机
    {
        if (Duty > 0) // 正转：对应物理左电机应使车体前进的转向
        {
            GPIO_SetBits(GPIOB, GPIO_Pin_14);   // BIN1 = 1, 修正后对应左电机
            GPIO_ResetBits(GPIOB, GPIO_Pin_15); // BIN2 = 0
            TIM2_SetPWM2_Duty(Duty);            // 使用 PWMB (TIM2_CH2)
        }
        else if (Duty < 0) // 反转
        {
            GPIO_SetBits(GPIOB, GPIO_Pin_15);   // BIN2 = 1, 修正后对应左电机
            GPIO_ResetBits(GPIOB, GPIO_Pin_14); // BIN1 = 0
            TIM2_SetPWM2_Duty(-Duty);           // 传入正值，注意取绝对值
        }
        // ... 停转处理 ...
    }
    else if (Motor_Id == Motor_R) // 右电机
    {
        if (Duty > 0) // 正转：对应物理右电机应使车体前进的转向
        {
            GPIO_SetBits(GPIOB, GPIO_Pin_13);   // AIN2 = 1, 修正后对应右电机
            GPIO_ResetBits(GPIOB, GPIO_Pin_12); // AIN1 = 0
            TIM2_SetPWM1_Duty(Duty);            // 使用 PWMA (TIM2_CH1)
        }
        else if (Duty < 0) // 反转
        {
            GPIO_SetBits(GPIOB, GPIO_Pin_12);   // AIN1 = 1, 修正后对应右电机
            GPIO_ResetBits(GPIOB, GPIO_Pin_13); // AIN2 = 0
            TIM2_SetPWM1_Duty(-Duty);           // 传入正值，注意取绝对值
        }
        // ... 停转处理 ...
    }
}
```

### 已验证结果

**BUG根因确认**：通过逻辑分析仪波形分析，100%确认了软件驱动层与硬件执行层之间的映射错位是导致转向抖动的根本原因。

**问题修复**：修正`Motor.c`中的引脚映射后，平衡车在所有工况下运行平稳，转向控制流畅且符合预期，正向与反向转向均能正确执行。

**系统稳定性恢复**：转向环、速度环、直立环的三环串级控制系统在修正映射后协同工作正常，消除了因底层执行错误导致的上层控制失稳。

### 下一步计划

**代码结构优化**：以此BUG为鉴，系统性地审查所有硬件驱动层（如电机、编码器、IMU、无线模块）的初始化与调用接口，确保其模块化、清晰化，并在关键位置增加关于硬件-软件映射关系的注释。

**完善和统一注释**：特别是在`Motor.c`、`PWM.c`等与硬件直接相关的驱动文件中，必须增加详细的注释，明确说明每个函数、每个参数控制的物理对象及其正方向定义，防止未来维护或移植时出现类似的隐蔽错误。

## 2026-05-25 | 项目完工、文档编制与开源发布

### **今日核心目标**

完成基于STM32F103C8T6的两轮自平衡车项目的全部开发、调试与收尾工作，将项目工程进行系统化整理、文档化，并公开发布，形成一个完整的、可用于展示的个人作品。

### 具体工作内容

**最终代码优化与Bug修复**：

 **问题修复**：针对`Key.c`中的按键检测模块，修复了一个潜在的状态竞争条件。在极短时间内连续按下并松开时，由于`Key_Mode`函数中的状态判断与`Key_Scan`中断中的标志位清零存在微小时间窗口，可能导致一次按键动作被误判两次。通过优化状态机的判断与清零顺序，确保了按键事件的唯一性和确定性。 **注释完善**：对整个工程的所有`.c`和`.h`文件进行了全面的注释审查与补充。统一了注释风格，在文件头增加了模块功能、作者、版本及修改历史说明，在关键函数和复杂逻辑处增加了清晰的步骤说明，极大提升了代码的可读性和可维护性。

**项目文档与成果物制作**： 

**README.md撰写**：编写了详尽的项目说明文档。内容涵盖：项目简介、硬件组成（STM32F103C8T6最小系统、MPU6050、TB6612、编码电机等）、软件架构（三环PID控制原理、模块化设计）、以及关键参数说明。文档结构清晰，便于他人复现和理解。 **演示视频录制与发布**：录制了高质量的项目演示视频，展示了平衡车开机稳定直立、抗干扰能力、遥控移动等全部核心功能。视频已上传至Bilibili平台，作为项目成果的动态展示。

**项目开源与发布**：

 在GitHub创建了新的代码仓库，遵循清晰的文件结构提交了所有源代码、配置文件及文档。 

### **下一步计划**：

**技术深化**：学习并尝试在现有平衡车系统中移植FreeRTOS实时操作系统，将姿态解算、PID控制、通信等任务模块化，并研究在RTOS调度下的系统性能与稳定性变化，进一步深入理解实时系统的设计理念。

**功能扩展**：探索为平衡车增加更多功能，如手机APP图形化控制器、路径规划、自主避障等，将其作为一个持续迭代的机器人开发平台。

# **项目总结**：

本项目始于2026年4月8日，历时48天，完成了从零开始构建一个基于STM32F103C8T6的两轮自平衡车系统的全过程。项目深入实践了嵌入式系统开发的全流程：硬件选型与焊接、外设驱动开发、实时控制系统设计、传感器数据融合、无线通信、系统调试与稳定性优化。成功解决了I2C死锁、转向控制正反馈、内存状态残留等多个典型且具有挑战性的嵌入式系统问题。最终，项目以完善的文档和开源形式呈现，充分展现了在嵌入式软硬件开发、问题解决与工程项目管理方面的综合能力。
