2268699403/Stm32_Project/原理图/平衡车系统板v3.pdf

电源转换电路 | 复位电路

## 电源指示灯

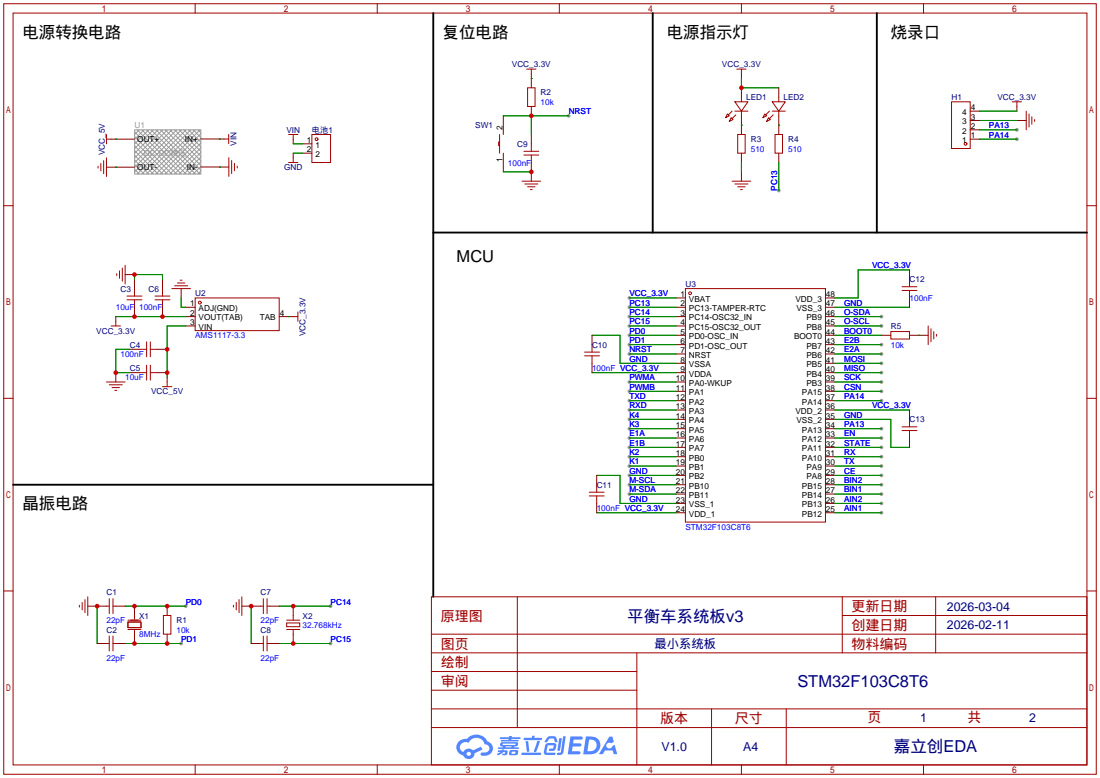
[picture p2: page 1]

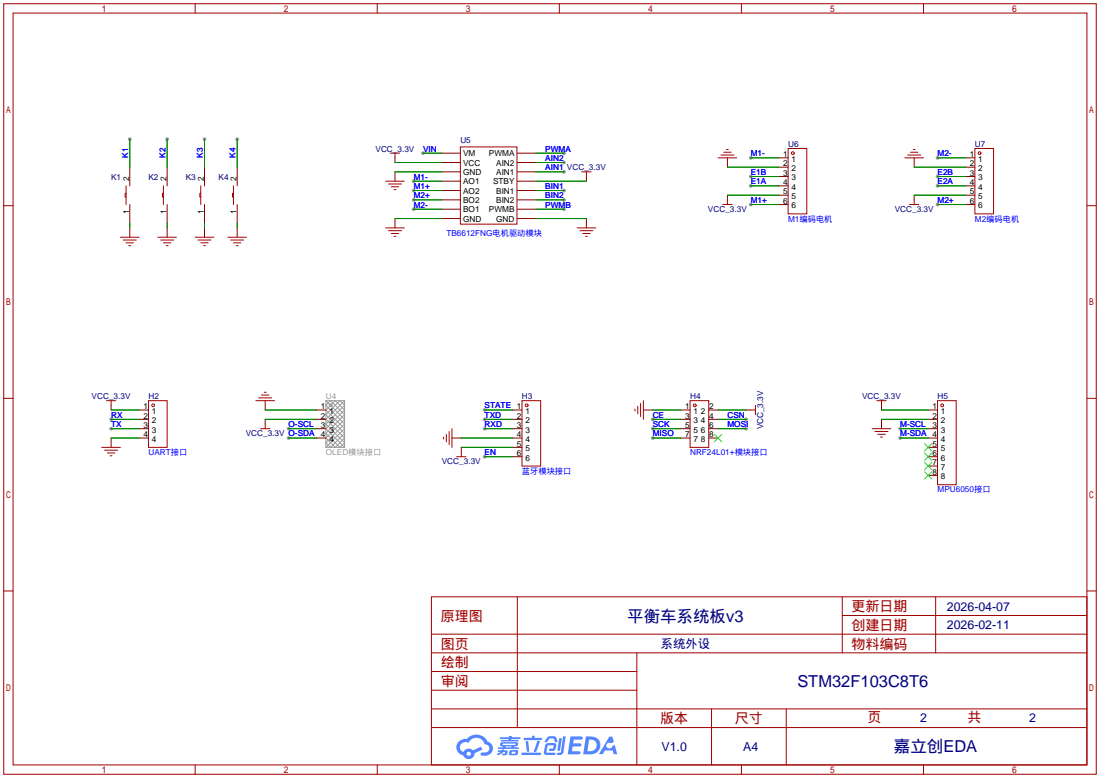
[picture p3: page 2]
