2268699403/Stm32_Project/原理图/PCB_平衡车PCBv3.pdf

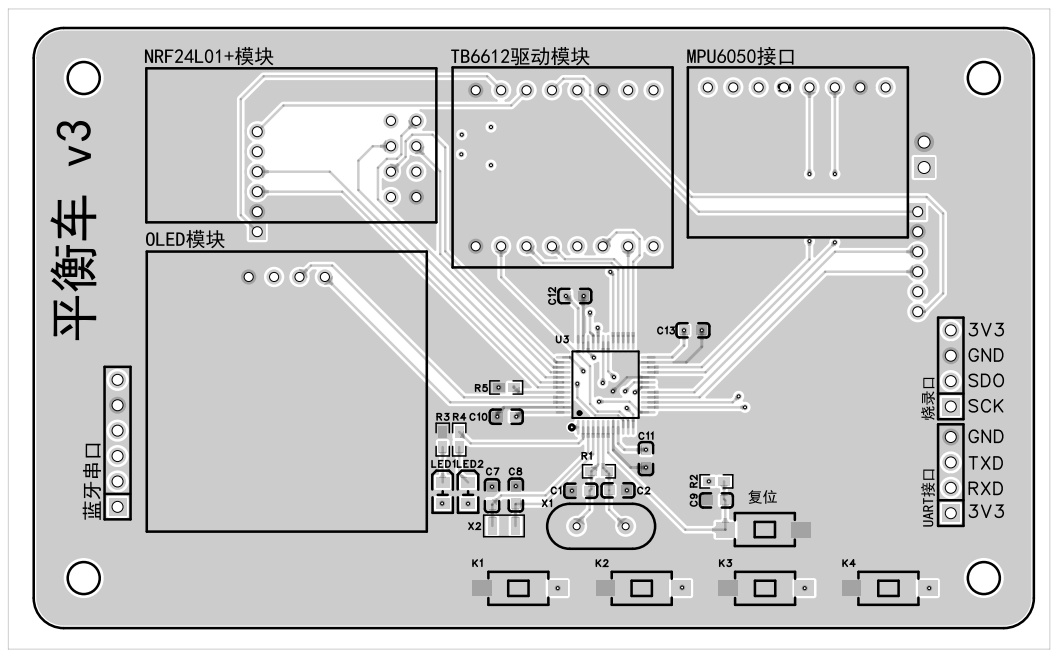
[picture p4: page 1]

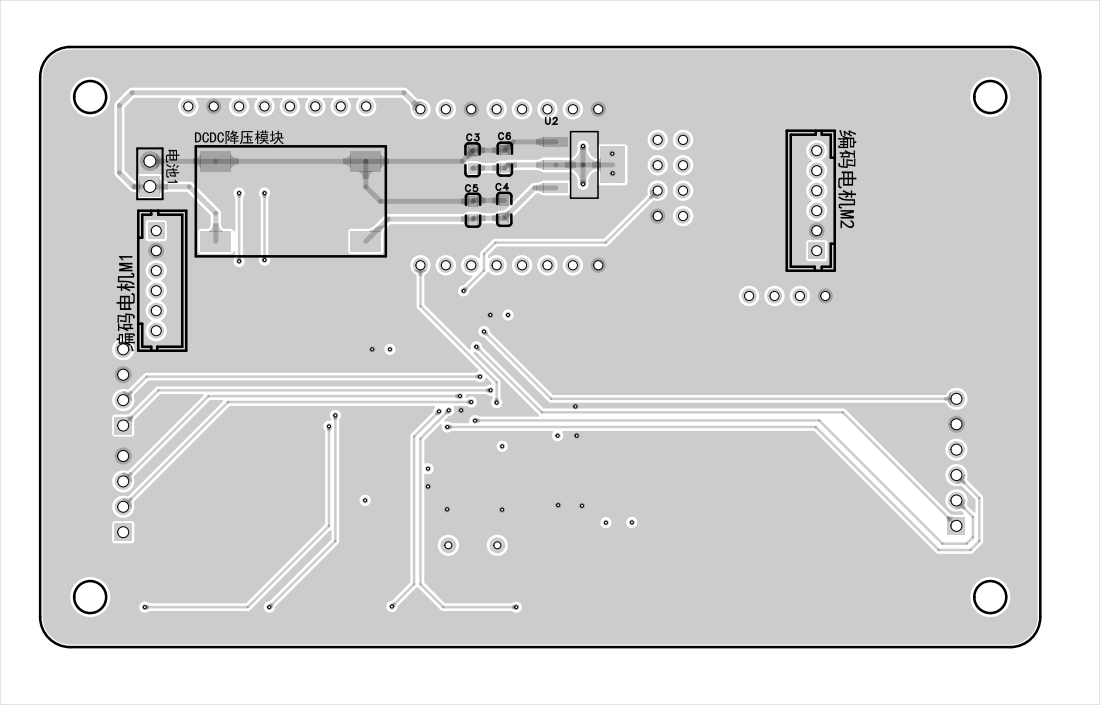
[picture p5: page 2]

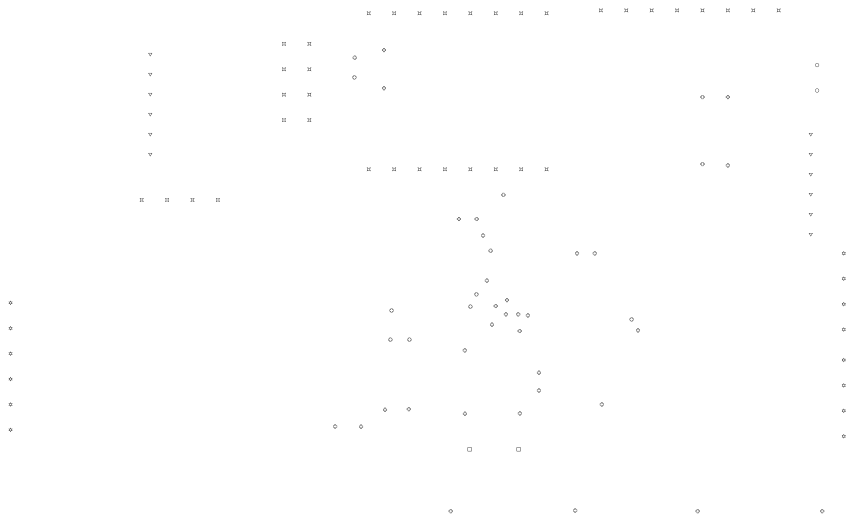
[picture p6: page 3]
