2268699403/Stm32_Project/原理图/PCB_遥控器PCB.pdf

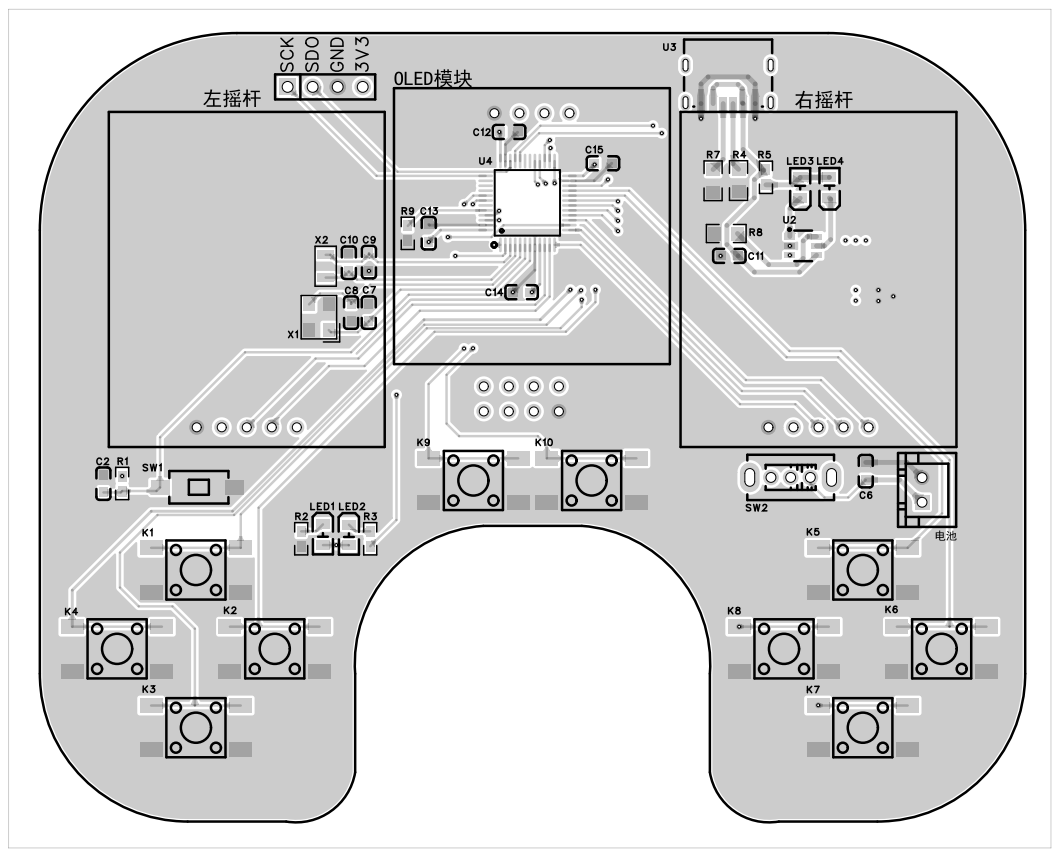
[picture p7: page 1]

## NRF24L01+

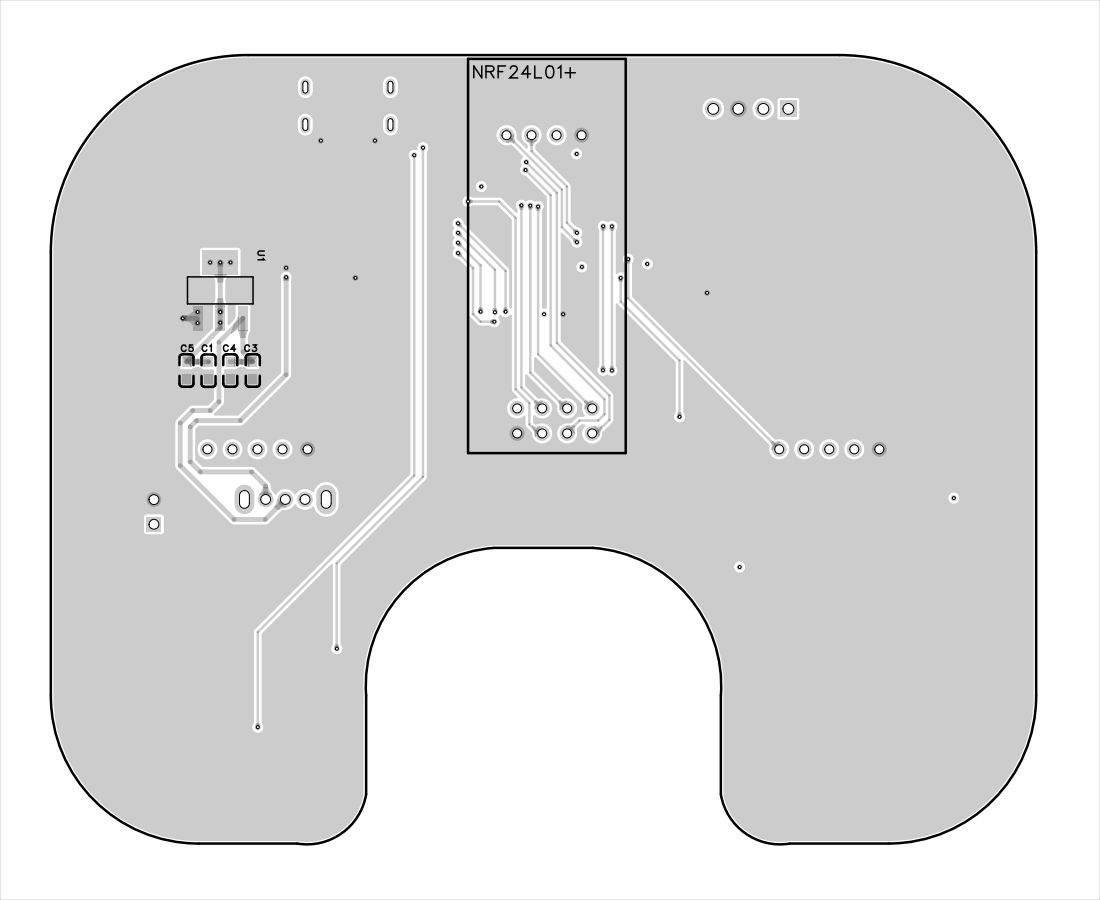
[picture p8: page 2]

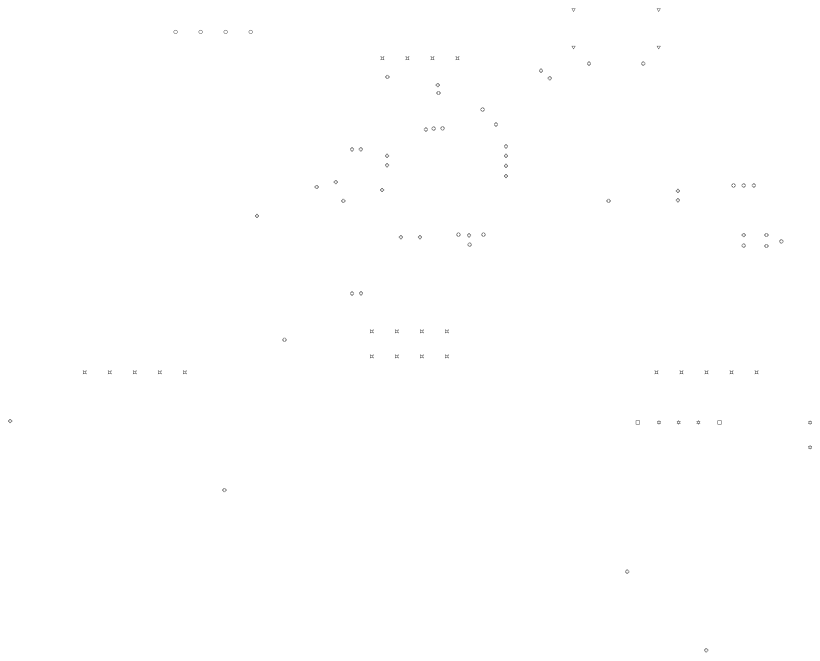
[picture p9: page 3]
