2268699403/Stm32_Project/原理图/遥控器系统板.pdf

## 电源转换电路

## 烧录口

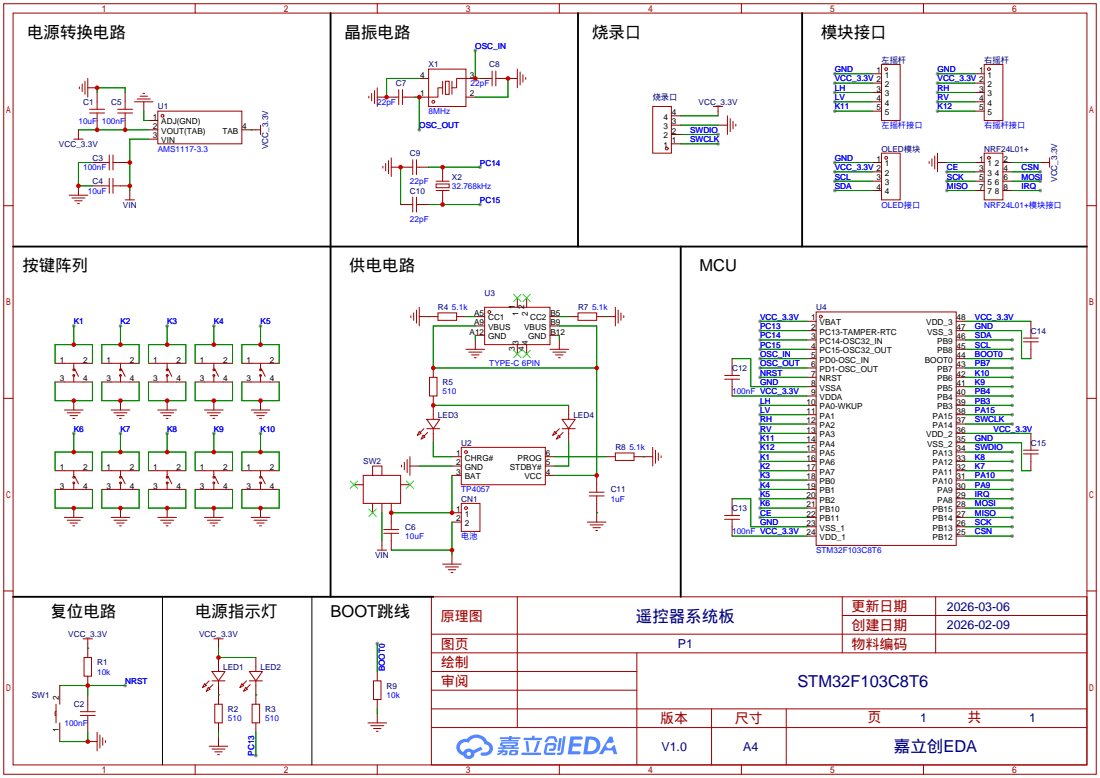
[picture p10: page 1]
