2268699403/Stm32_Project/基于stm32f103的两轮自平衡车/平衡车_FreeRTOS/Hardware/Key.h

#ifndef __KEY_H
#define __KEY_H

#define Key_1 GPIO_Pin_1
#define Key_2 GPIO_Pin_0
#define Key_3 GPIO_Pin_5
#define Key_4 GPIO_Pin_4

extern uint8_t Key1_Mode;
extern uint8_t Key2_Mode;
extern uint8_t Key3_Mode;
extern uint8_t Key4_Mode;

extern uint8_t Key1_LongTriggered;
extern uint8_t Key2_LongTriggered;
extern uint8_t Key3_LongTriggered;
extern uint8_t Key4_LongTriggered;

void Key_Init(void);
void Key_Scan(void);
void Key_Mode(void);


#endif
