2268699403/Stm32_Project/基于stm32f103的两轮自平衡车/平衡车_FreeRTOS/Hardware/USART1.h

#ifndef __USART1_H
#define __USART1_H

#define BaudRate 9600

void USART1_Init(void);
void USART1_SendByte(uint8_t Data);
void USART1_SendString(char *String);
void USART1_Printf(char *format, ...);

#endif
