2268699403/Stm32_Project/(commit log)

2026-04-06 移植了0.96OLED驱动，新建了1ms的定时中断
2026-04-06 添加了制版相关文件
2026-04-12 上传模块驱动
    修改并上传模块驱动，新增日志
2026-04-13 修改日志（下一计划）
    由于换板时拆除TB6612模块至损坏，原计划“电机驱动基础”开发改为“姿态解算基础”开发。
2026-04-13 完成姿态传感器的核心驱动开发
    配置STM32的硬件I2C2外设，实现底层的单字节与多字节读写函数。
    完成MPU6050模块的初始化、寄存器配置，并成功读取其原始的加速度计、陀螺仪及温度数据。
    修改了现有模块的头文件关系，提升代码抗风险能力。
    更新了今日的日志内容
2026-04-17 电机驱动与控制执行器开发
    配置TIM2定时器的两路PWM输出通道，生成用于电机调速的PWM波形；
    编写完整的电机驱动模块，实现对左右电机正转、反转、停止三种状态以及无级调速的精确控制。
    在尝试为MPU6050的I2C通信配置DMA时，程序在I2C_CheckEvent的等待循环中卡死，初步判断为I2C总线状态机与DMA传输时序冲突导致的死锁。为确保项目主干进度，决定暂时搁置DMA优化，维持当前查询式读取。此优化将在主体控制算法稳定后，作为性能提升点重新评估。
2026-04-18 编码器测速与蓝牙模块重置
    完成TIM3和TIM4的正交编码器接口模式配置，以捕获电机编码器脉冲。
    在系统1ms定时中断中周期性地读取并计算左右电机的实时转速（RPM）与方向。
    重置蓝牙模块，为后续的无线调参与监控做好准备。
2026-04-19 优化了基础模块代码结构
    完善了基础驱动模块的代码注释，增加代码可读性。
    优化了按键检测逻辑，现在长按超过1秒就置长按标志位，并且释放时不与短按冲突。
2026-04-19 传感器融合与姿态解算实现
    按键逻辑优化：
    将Key_Mode函数的判断逻辑从“仅在松手(Released)时判决”优化为“长按超过1秒（count >= 50）时立即更新状态，短按仍在松手时判决”。
    姿态解算算法实现与调试：
    计算得到加速度计俯仰角和陀螺仪俯仰角。采用一阶互补滤波公式 Angle = Kp * AngleAcc + (1 - Kp) * AngleGyro计算出稳定的俯仰姿态角。对陀螺仪Y轴数据进行了零偏校准（pData->Gyro_Y -= 43），以抑制其零点漂移。
    系统调度与架构优化：
    将MPU6050_GetRawData函数的调用从主循环移至TIM1的1ms定时中断服务函数中，并设置为每10ms执行一次。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
2026-04-20 直立环PID控制实现与系统调优
    成功修复了蓝牙模块的通信功能。通过上位机软件实时接收并图形化显示角度目标值、实际值及PID输出的波形，为PID参数整定提供了直观、高效的视觉反馈工具。
    重构了Motor_Direction函数，将电机“方向”与“速度”的控制逻辑统一。函数输入参数Duty为int16_t类型的有符号数，其符号代表转向（正为前进，负为后退），绝对值代表PWM占空比。此举简化了上层控制逻辑，使PID输出可直接作为电机输入。
    在PID.c中实现了增量式PID算法，依次调节Kp（影响回复力刚度）、Kd（抑制振荡）和Ki（消除稳态误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
    [MPU6050.c, Motor.c, Motor.h, PID.c, PID.h, Timer.c, main.c]
2026-04-24 速度环开发
    实现了速度环控制。
    目前代码存在严重bug，程序在下载后运行正常，断电重新上电运行时，PID_Speed.Actual始终自增到2.1左右，电机逐渐加速到最大，该BUG稳定复现且现象一致。
    暂时恢复方式是下载其它程序后，重新下载速度环控制程序，但断电再上电依旧触发BUG
2026-04-24 实现了稳定的速度环控制
    修复了BUG，实现了稳定的速度环控制，不会因为重新上电而触发BUG，并优化了控制结构，增加了积分清除机制。
2026-04-24 优化了代码结构
    优化代码结构，稳定运行速度环
2026-04-24 速度环闭环控制与无线调参实现
    在PID.c中编写了PID_Speed_Update函数。该函数计算左右电机编码器转速的平均值(AveSpeed)作为速度环的反馈量(`Actual`)。
    在USART2.c中强化了USART2_ParseParam函数。该函数在中断接收的环形缓冲区中，解析格式为“参数名:值”的字符串（如“Kp:0.5”）。
    在Timer.c的中断服务函数中，以50ms为周期调用PID_Speed_Update函数。 关键优化：对中断服务函数中的控制逻辑进行了重构，明确了En（平衡使能标志）在不同状态下的行为，并确保在异常状态（如倾角超限）下，能彻底重置所有PID控制器的积分项和目标值，从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
2026-04-25 转向闭环控制与无线遥控系统集成
    转向环控制器实现与整合：在PID.c中，基于已定义的PID_Turn结构体，完成了PID_Move_Update函数。在同一个函数中，同步处理速度环和转向环。速度环输出用于补偿直立环目标角度，以抑制静漂；转向环输出则作为差速控制量，用于后续的电机PWM分配，实现转向。
    无线遥控系统集成：
    移植NRF24L01.c驱动代码到工程中，并完成引脚初始化。在main.c的主循环中，持续调用NRF24L01_Receive()函数查询接收状态。当成功接收到遥控器发来的数据包后，解析数据包。
2026-04-26 速度环PID调控
    参数合适
2026-05-20 转向BUG的分析与修复
2026-05-25 项目总结
    本项目始于2026年4月8日，历时48天，完成了从零开始构建一个基于STM32F103C8T6的两轮自平衡车系统的全过程。
    项目深入实践了嵌入式系统开发的全流程：硬件选型与焊接、外设驱动开发、实时控制系统设计、传感器数据融合、无线通信、系统调试与稳定性优化。成功解决了I2C死锁、转向控制正反馈、内存状态残留等多个典型且具有挑战性的嵌入式系统问题。
    最终，项目以完善的文档和开源形式呈现，充分展现了在嵌入式软硬件开发、问题解决与工程项目管理方面的综合能力。
    [Encoder.c, Key.c, Key.h, MPU6050.c, Motor.c, PID.c, PWM.c, main.c]
2026-07-11 新增Freertos
2026-07-11 参数整定
    提升了直线行驶时的稳定性
2026-07-16 ESP32拓展规划
    新建了ESP32拓展功能的计划
